zhandos717/esp32-voice-box/hardware/enclosure/body_view.png

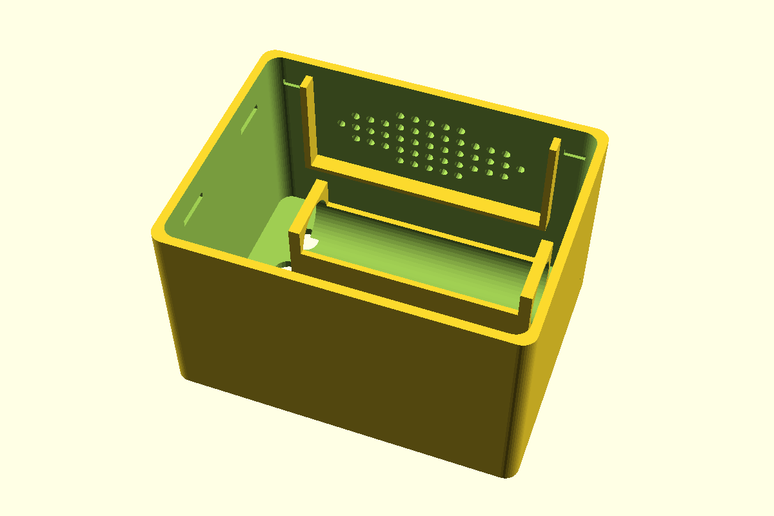
hardware/enclosure/body_view.png
