zhandos717/esp32-voice-box/hardware/enclosure/buttons_preview.png

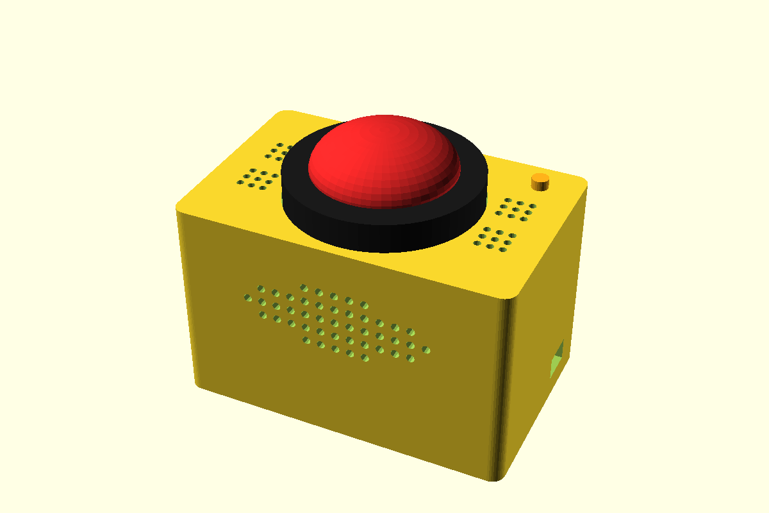
hardware/enclosure/buttons_preview.png
