zhandos717/esp32-voice-box/hardware/enclosure/floor_under.png

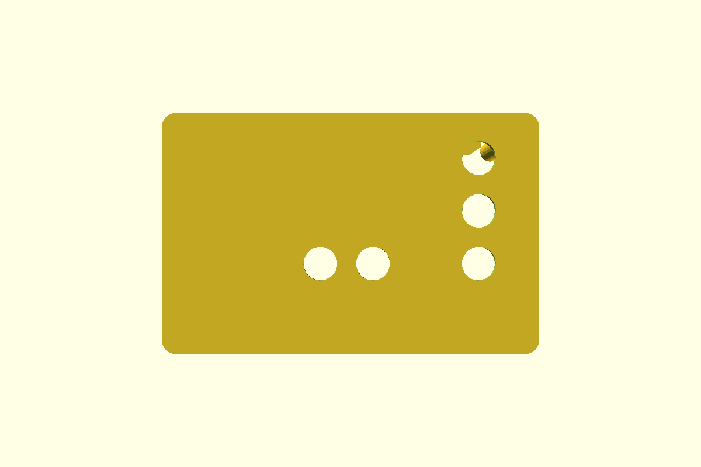
hardware/enclosure/floor_under.png
