zhandos717/esp32-voice-box/hardware/enclosure/inside.png

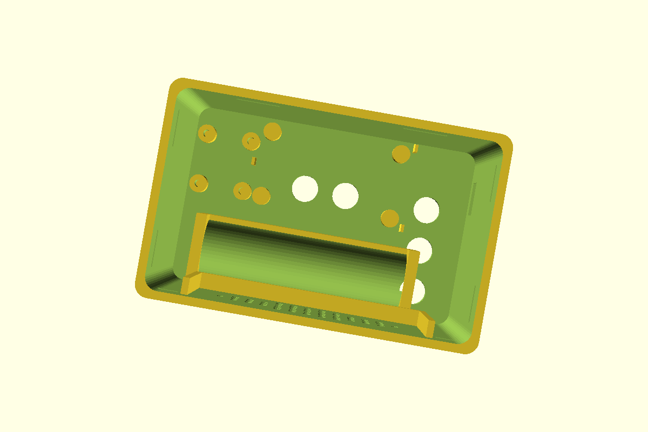
hardware/enclosure/inside.png
