zhandos717/esp32-voice-box/hardware/enclosure/inside_front.png

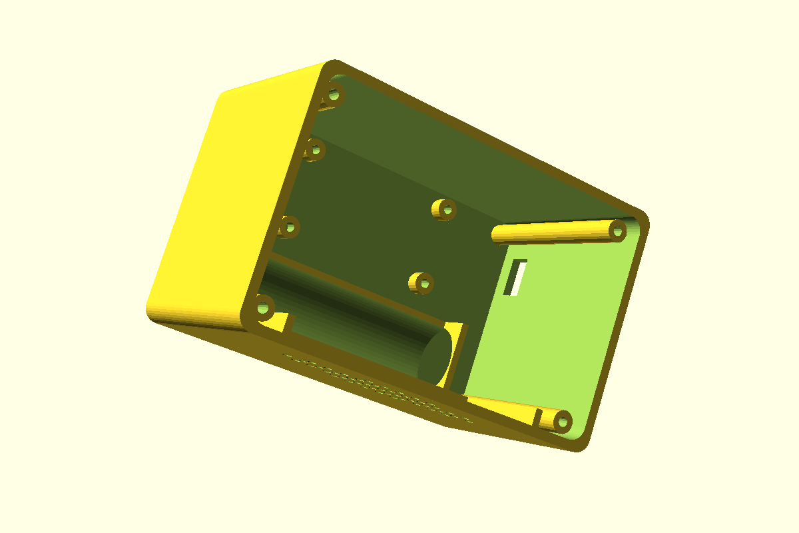
hardware/enclosure/inside_front.png
