zhandos717/esp32-voice-box/hardware/enclosure/lid_top.png

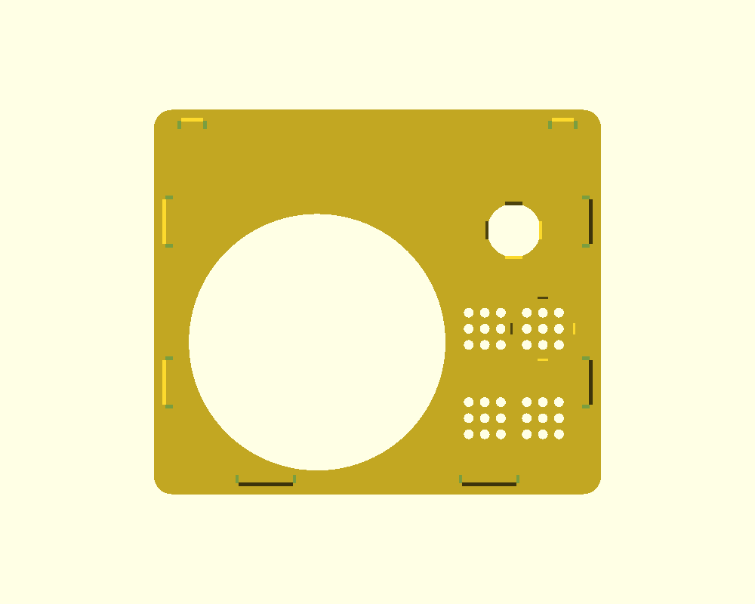
hardware/enclosure/lid_top.png
