zhandos717/esp32-voice-box/hardware/enclosure/lid_view.png

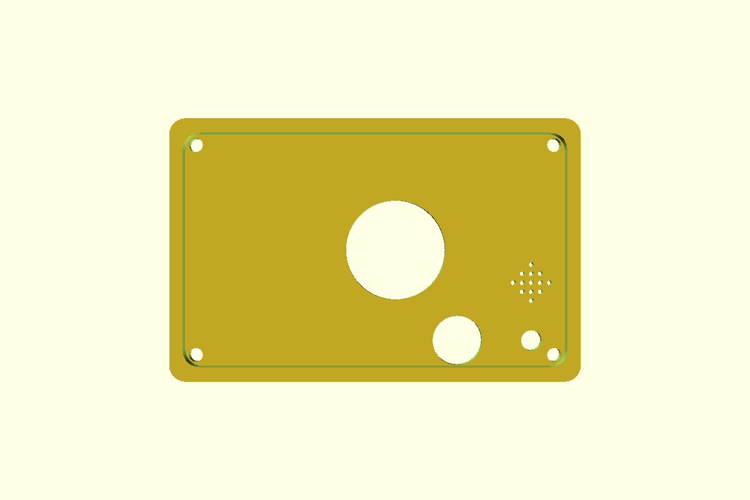
hardware/enclosure/lid_view.png
