zhandos717/esp32-voice-box/hardware/enclosure/mic_under.png

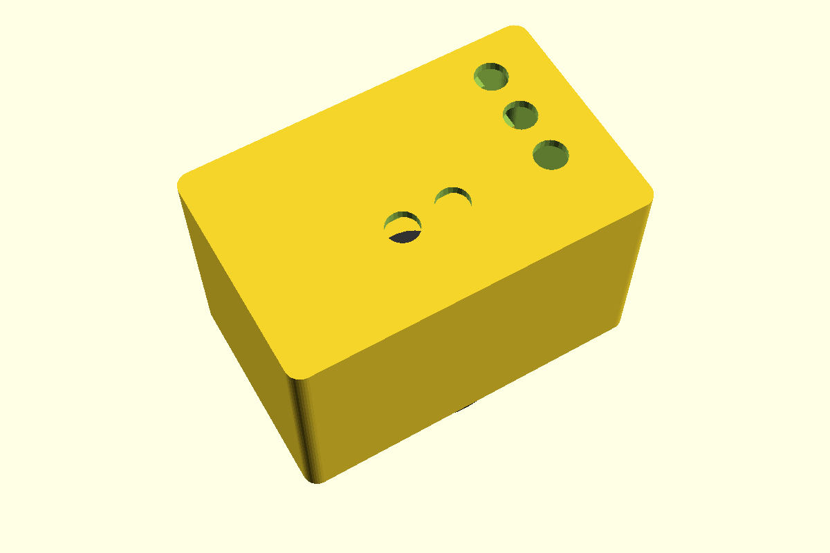
hardware/enclosure/mic_under.png
