zhandos717/esp32-voice-box/hardware/enclosure/lid.stl

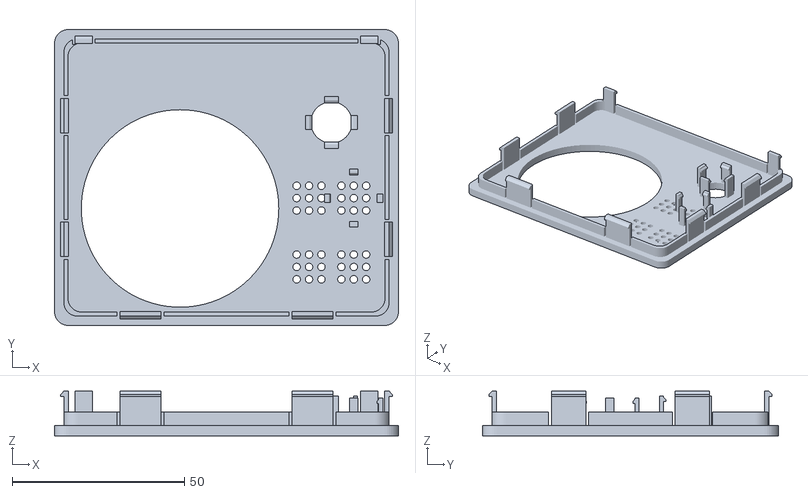
[picture p10: CAD file, 2026-11-04]
hardware/enclosure/lid.stl
100.0 x 86.0 x 13.0
