zhandos717/esp32-voice-box/hardware/enclosure/print_bambu.stl

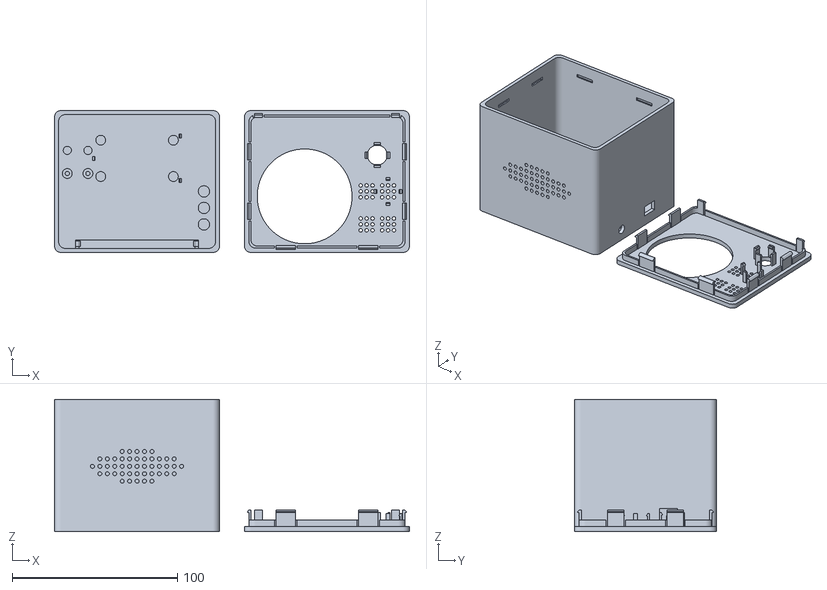
[picture p11: CAD file, 2026-11-04]
hardware/enclosure/print_bambu.stl
215.0 x 86.0 x 80.0
