zhandos717/esp32-voice-box/hardware/enclosure/body.stl

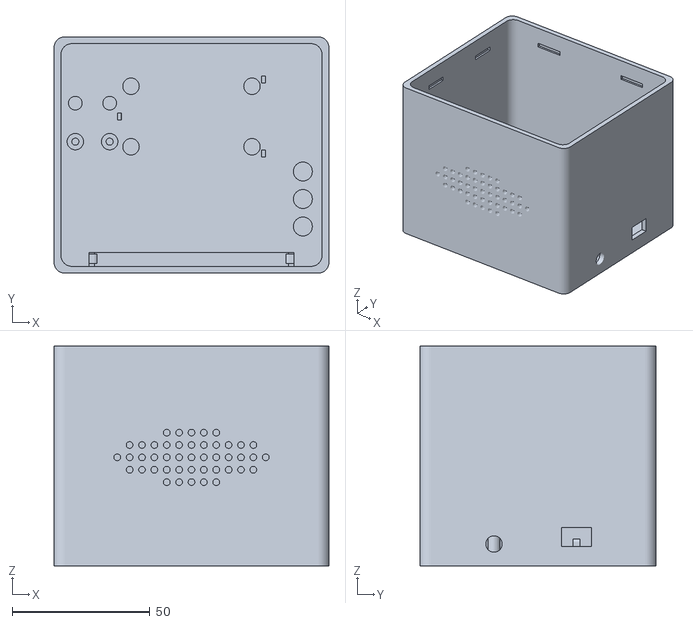
[picture p12: CAD file, 2026-11-04]
hardware/enclosure/body.stl
100.0 x 86.0 x 80.0
