zhandos717/esp32-voice-box/(commit log)

2026-11-04 ESP32 voice box: mic, speaker, Telegram bridge, OTA
    ESP32 + INMP441 microphone + MAX98357A speaker. Hold-to-record button,
    Go server with web UI, Telegram two-way bridge, queue of incoming
    messages, sound library, over-the-air firmware updates, enclosure model.
    [body.stl, buttons_preview.scad, enclosure.scad, lid.stl, print_bambu.stl]
2026-11-04 Server password for the board, heartbeat, keepalive, sounds, VPS deployment notes
    - MIC3 handshake: the board sends a password, the server (MIC_TOKEN) rejects others
    - firmware: heartbeat during long playback / OTA, TCP keepalive, partial USB provisioning
    - sound library with selection on the web page, OTA updates over the server connection
    - docs/deploy-vps.md: running the server on a VPS
2026-11-04 Telegram Mini App login for the web page, blinking record LED
    The page can be published through a proxy as a Mini App when MIC_WEB_URL is set:
    the API is closed until Telegram initData of an allowed user (MIC_WEB_USERS or the
    paired private chat) is verified, then a session cookie is set. The bot gets a
    menu button that opens the page. The record LED on GPIO4 blinks while recording.
2026-11-04 IMA ADPCM audio both ways, larger playback buffer, no reminder burst after playback
    The board announces ADPCM with 4 in the header's bits field; the server keeps PCM for
    older firmware. Audio traffic drops from 32 to 8 KB/s. The playback buffer grows to
    2.5 s (starts after 1 s), the microphone buffer shrinks to 1 s. Reminders queued up
    while a message was playing are dropped by the board.
2026-11-04 OTA trial with rollback, microphone high-pass and soft limiter, amplifier shutdown, max Wi-Fi TX power
    A new OTA image must keep a server connection for a minute within 3 minutes and 3 boots,
    otherwise the board boots the previous slot again. The microphone gets a 120 Hz high-pass
    (DC offset and hum) and a soft limiter before ADPCM. MAX98357A SD on GPIO23 switches the
    amplifier off in silence. Wi-Fi TX power is set to the maximum.
2026-11-05 Board telemetry every 15 s, shown in the web page
    The board sends a JSON frame (type 10): uptime, heap, Wi-Fi signal, channel, access point,
    TX power, reset reason, Wi-Fi drops, server reconnects, longest loop stall, audio lost
    while recording, playback underruns and the OTA trial state. /api/status returns it with
    the server's own view of the connection; the page shows it as a card.
    [mic_stream.ino]
2026-11-05 Read text messages aloud: Azure AI Speech or Piper, cartoon voice effects
    A text message in the paired chat is synthesised and queued for the board like a voice
    message. Azure AI Speech is used when AZURE_SPEECH_KEY/REGION are set (16 kHz WAV directly),
    Piper otherwise. TTS_PITCH/TTS_RATE add SSML prosody, TTS_EFFECT=chipmunk|robot runs
    the speech through an ffmpeg filter.
2026-11-05 Pick the voice for text messages in the web page, with a test on the board
    Voice presets (the sample page's voices) for Russian and Kazakh text are stored in
    settings.json and override .env; /api/voice/test says a sample phrase on the board.
2026-11-05 Keep recording 2.5 s after the button is released, trim the quiet end
    Children let go before the last word. The server keeps the board streaming for
    MIC_TAIL_MS after the release; a new press in that time continues the same recording.
    The release click is ducked like the press click and the silent end of the tail is cut.
2026-11-05 Reject a board header with a sample rate outside 8-48 kHz; guard trimSilence
2026-11-05 Find the press click up to 250 ms before the reported press and dip it
    The arcade button clicks on its way down and the board's audio lags, so the click
    landed before the fixed dip window. The server now looks for a short burst above the
    room level near the press and ducks exactly that; with speech before the press it
    falls back to the old window.
2026-11-05 Pult: switch the interface between Russian, Kazakh and English
2026-11-08 Chipmunk voices: keep the pitch, speak only 10% faster than normal
2026-11-09 Wi-Fi setup from a phone and battery level (#21)
2026-11-09 Микрофон в Opus (#22)
    * Opus from the microphone
    * Cap Opus recordings by packet count
2026-11-11 Лицензия: PolyForm Noncommercial 1.0.0 (#24)
    * Switch license to PolyForm Noncommercial 1.0.0
    * Restore files removed by mistake
